kapikep/PeugeotOnboardComputer2.0/Photo/IMG_20211120_220645.jpg

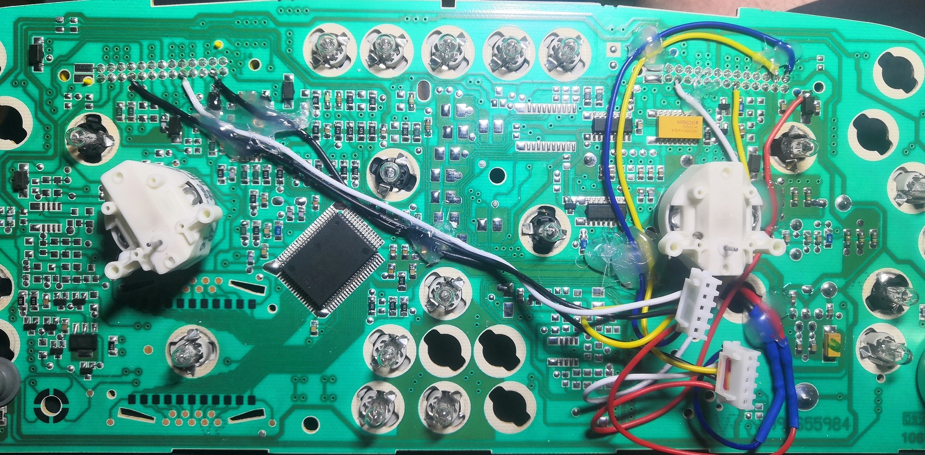
Photo/IMG_20211120_220645.jpg
