kapikep/PeugeotOnboardComputer2.0/Photo/IMG_20220521_182858.jpg

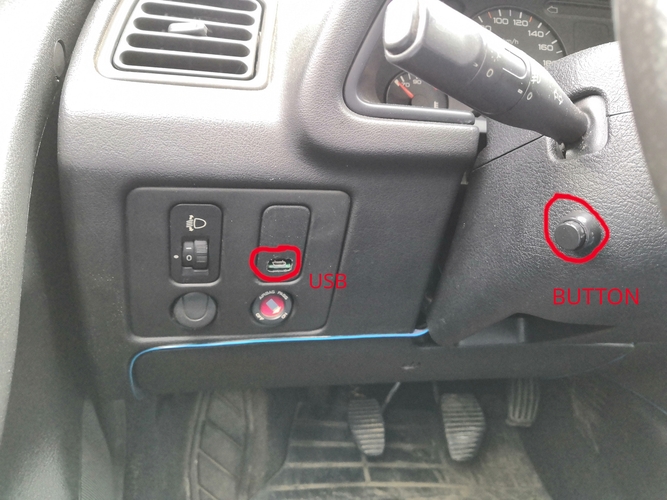
Photo/IMG_20220521_182858.jpg
