kapikep/PeugeotOnboardComputer2.0/README.md

Arduino onboard computer for Peugeot 306 1.6 (no CAN). Control system Bosch 7.2

Functions:

Engine speed, car speed, interior temperature, engine temperature, voltmeter, injection time, fuel consumption, instant and average fuel consumption, distance to refueling, changing the volume of the radio JVC remote according to speed.

Built into the dashboard.

Electronic Fuel Injector Flow Data Table http://users.erols.com/srweiss/tableifc.htm

Connection (1999 MY)

Dashboard Blue connector:

    pin 15 - +15 (Ignition)
    pin 13 - Negative
    pin 25 - +30 (Battery)
    pin 21 - Speed engine

Dashboard Yellow connector:

    pin 5 - Temp engine
    pin 2 - Speed car
    pin 10 - Fuel

Сontrol unit (injector) pin 53 or 54

Components:

- Arduino nano
- 1.8 inch TFT LCD Module
https://aliexpress.ru/item/32841982669.html?item_id=32841982669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
- 5 pin socket 2pcs
- 2 pin connector
- LM7805
- EL817
- Button
- TDA2822
- BSS315
- 2N7000
