kapikep/PeugeotOnboardComputer2.0/Photo/IMG_20211121_003405.jpg

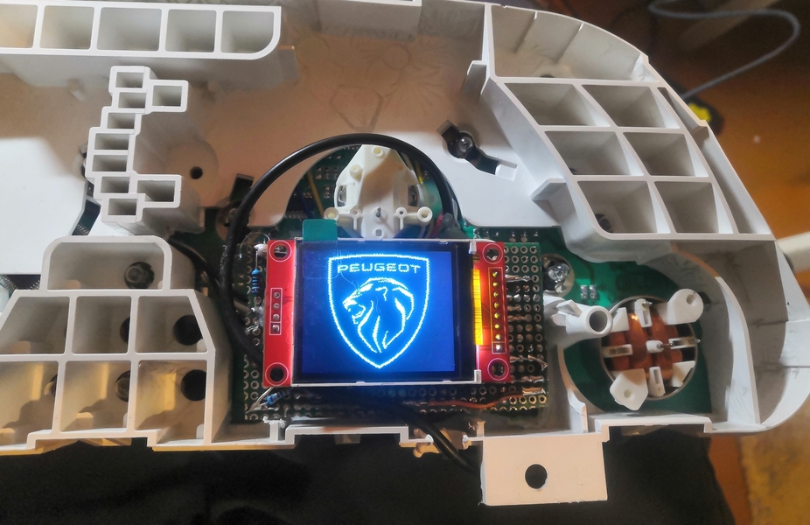
Photo/IMG_20211121_003405.jpg
