kapikep/PeugeotOnboardComputer2.0/Schematic_Onboard_2022-03-15.png

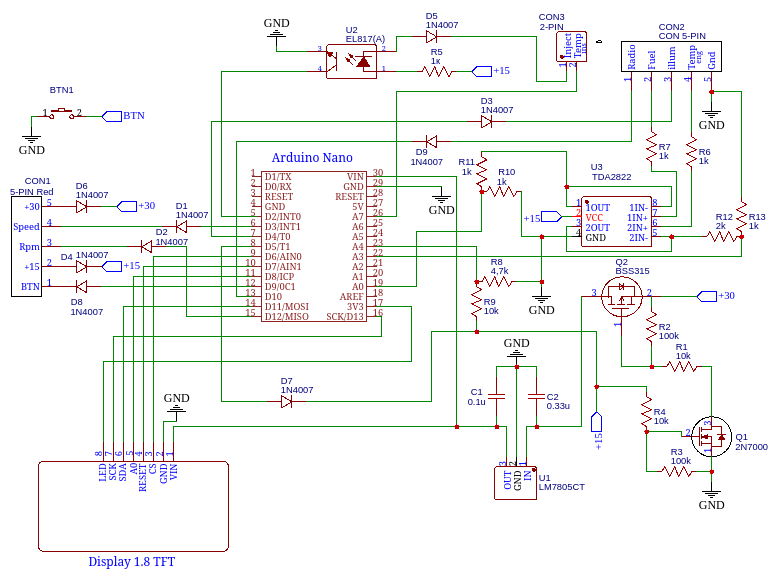
Schematic_Onboard_2022-03-15.png
