kapikep/PeugeotOnboardComputer2.0/PeugeotOnboardComputer/Bitmaps.h

const int temp_matrix[][2]{
  { 485, -10 },
  { 480, -5 },
  { 475, 0 },
  { 470, 5 },
  { 465, 10 },
  { 455, 15 },
  { 445, 20 },
  { 440, 25 },
  { 435, 30 },
  { 425, 35 },
  { 415, 40 },
  { 400, 45 },
  { 390, 50 },
  { 370, 55 },
  { 360, 60 },
  { 350, 65 },
  { 330, 70 },
  { 315, 75 },
  { 300, 80 },
  { 295, 81 },
  { 290, 82 },
  { 285, 83 },
  { 280, 84 },
  { 275, 85 },
  { 270, 86 },
  { 265, 87 },
  { 260, 88 },
  { 255, 89 },
  { 250, 90 },
  { 245, 91 },
  { 240, 92 },
  { 235, 93 },
  { 230, 94 },
  { 225, 95 },
  { 220, 96 },
  { 215, 97 },
  { 210, 98 },
  { 205, 99 },
  { 200, 100 },
  { 195, 101 },
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
};

const uint8_t lion[] PROGMEM ={
0x00, 0x00, 0x00, 0x00, 0x00, 0x00, 0x00, 0x00, 0x00, 0x00, 0x00, 0x00, 0x00, 0x00, 0x00, 
0x00, 0x00, 0x00, 0x00, 0x00, 0x00, 0x00, 0x00, 0x00, 0x00, 0x00, 0x00, 0x00, 0x00, 0x00, 
0x00, 0x00, 0x00, 0x00, 0x00, 0x00, 0x00, 0x00, 0x00, 0x00, 0x00, 0x00, 0x00, 0x00, 0x00, 
0x00, 0x00, 0x00, 0x00, 0x00, 0x00, 0x09, 0x24, 0x00, 0x00, 0x00, 0x00, 0x00, 0x00, 0x00, 
0x00, 0x00, 0x00, 0x00, 0x57, 0xff, 0xff, 0xff, 0xff, 0xfd, 0x40, 0x00, 0x00, 0x00, 0x00, 
0x00, 0x00, 0x01, 0x7f, 0xff, 0xff, 0xff, 0xff, 0xff, 0xff, 0xff, 0xe8, 0x00, 0x00, 0x00, 
0x00, 0x01, 0x7f, 0xff, 0xd4, 0x00, 0x00, 0x00, 0x00, 0x02, 0xff, 0xff, 0xe8, 0x00, 0x00, 
0x00, 0xbf, 0xff, 0x40, 0x00, 0x00, 0x00, 0x00, 0x00, 0x00, 0x00, 0x17, 0xff, 0xd0, 0x00, 
0x0f, 0xff, 0x40, 0x00, 0x00, 0x00, 0x00, 0x00, 0x00, 0x00, 0x00, 0x00, 0x2f, 0xff, 0x00, 
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
0x0c, 0x00, 0x00, 0x00, 0x01, 0x0f, 0xc0, 0x00, 0x00, 0x00, 0x78, 0x00, 0x00, 0x03, 0x00, 
0x0c, 0x00, 0x00, 0x00, 0x02, 0x3f, 0x80, 0x00, 0x00, 0x00, 0x1c, 0x00, 0x00, 0x03, 0x00, 
0x0c, 0x00, 0x00, 0x00, 0x00, 0xff, 0x80, 0x03, 0x80, 0x01, 0x06, 0x00, 0x00, 0x03, 0x00, 
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
};
