kapikep/PeugeotOnboardComputer2.0/(commit log)

2022-12-16 Temperature changing
2023-04-16 Refactor reset odo, add rawDataSreen()
    [PeugeotOnboardComputer.ino, Screen.ino]
2023-11-13 Fix full tank error, add fill tank algorithm
    [PeugeotOnboardComputer.ino, Screen.ino]
2023-11-22 Fix screen load problem, move 5 screen to additonial menu, max consump 99
    Fix screen load problem, move 5 screen to additonial menu, max consump 99
    [PeugeotOnboardComputer.ino, Screen.ino]
2025-05-17 New big speed counter, add motor operating
    New big speed counter, add motor operating and oil service
